luckyo7/MouseVR/Hardware/driver_board/production/JLCPCB BOM.xls

JLCPCB BOM Tool - BOM Matching
BOM name：bom-JLCPCB Assembly Order.xlsx |  |  | Download Time：2026-08-20 01:07:51 |  |  |  | * Our matching results are updated in real-time, but stock and prices may change. If it's been over 24 hours, please re-match before placing your order.
PCB Assembled Qty：5 |  |  | Est. Total Price：6.3515
Your BOM |  |  |  | Matched Parts |  |  |  |  |  |  | Order Information
Designator | Comment | Footprint | JLCPCB Part # | Matches | Part # | Manufacturer | Footprint | Description | Category | Warning | JLCPCB Part # | Product link | Lib Type | Qty | Source | Total Price ($)
C1 | 10u | 0805 |  | Unconfirmed | GRM21BR61H106KE43L | Murata Electronics | 0805 | 10uF 50V X5R ±10% 0805 Multilayer Ceramic Capacitors MLCC - SMD/SMT ROHS | Multilayer Ceramic Capacitors MLCC - SMD/SMT | 1.The comment (GRM21BR61H106KE43L) of this part does not match the one (10u) provided in your BOM. Please confirm; | C440198 | https://jlcpcb.com/partdetail/439567-GRM21BR61H106KE43L/C440198 | Basic | 5 | 5 JLCPCB | 1.2415
C2 | 1u | 0603 |  | Unconfirmed | CL10A105KB8NNNC | Samsung Electro-Mechanics | 0603 | 1uF 50V X5R ±10% 0603 Multilayer Ceramic Capacitors MLCC - SMD/SMT ROHS | Multilayer Ceramic Capacitors MLCC - SMD/SMT | 1.The comment (CL10A105KB8NNNC) of this part does not match the one (1u) provided in your BOM. Please confirm; | C15849 | https://jlcpcb.com/partdetail/16531-CL10A105KB8NNNC/C15849 | Basic | 20 | 20 JLCPCB | 0.544
C3,C4 | 100n | 0603 |  | Unconfirmed | CC0603KRX7R9BB104 | YAGEO | 0603 | 100nF 50V X7R ±10% 0603 Multilayer Ceramic Capacitors MLCC - SMD/SMT ROHS | Multilayer Ceramic Capacitors MLCC - SMD/SMT | 1.The comment (CC0603KRX7R9BB104) of this part does not match the one (100n) provided in your BOM. Please confirm; | C14663 | https://jlcpcb.com/partdetail/YAGEO-CC0603KRX7R9BB104/C14663 | Basic | 20 | 20 JLCPCB | 0.348
J2,J3 | Conn_01x12 | Hirose_FH12-12S-0.5SH_1x12-1MP_P0.50mm_Horizontal |  | Select by Customer | FH12-12S-0.5SH(55) | HRS(Hirose) | SMD,P=0.5mm,卧贴 | -40℃~+85℃ 0.3mm 0.5mm 12P 2mm Bottom Contact Gold Hinged Lid Phosphor bronze Surface Mount, Right Angle SMD,P=0.5mm,卧贴 FFC, FPC (Flat Flexible) Connector Assemblies ROHS | FFC, FPC (Flat Flexible) Connector Assemblies |  | C88360 | https://jlcpcb.com/partdetail/HRS_Hirose-FH12_12S_0_5SH_55/C88360 | Extended | 10 | 10 JLCPCB | 3.431
Q1 | Q_NPN_BEC | SOT-23 |  | Select by Customer | MMBT3904LT1G | onsemi | SOT-23 | -55℃~+150℃ 1 NPN 200mA 200mV 225mW 300MHz 40 40V 50nA 6V NPN SOT-23 Bipolar (BJT) ROHS | Bipolar (BJT) |  | C81464 | https://jlcpcb.com/partdetail/onsemi-MMBT3904LT1G/C81464 | Extended | 10 | 10 JLCPCB | 0.167
R1,R2,R3,R4,R5,R6 | 33R | 0603 |  | Unconfirmed | 0603WAF330JT5E | UNI-ROYAL(Uniroyal Elec) | 0603 | -55℃~+155℃ 100mW 33Ω 75V Thick Film Resistor ±1% ±100ppm/℃ 0603 Chip Resistor - Surface Mount ROHS | Chip Resistor - Surface Mount | 1.The comment (0603WAF330JT5E) of this part does not match the one (33R) provided in your BOM. Please confirm; | C23140 | https://jlcpcb.com/partdetail/23867-0603WAF330JT5E/C23140 | Basic | 40 | 40 JLCPCB | 0.188
R7 | 1K | 0603 |  | Unconfirmed | 0603WAF1001T5E | UNI-ROYAL(Uniroyal Elec) | 0603 | -55℃~+155℃ 100mW 1kΩ 75V Thick Film Resistor ±1% ±100ppm/℃ 0603 Chip Resistor - Surface Mount ROHS | Chip Resistor - Surface Mount | 1.The comment (0603WAF1001T5E) of this part does not match the one (1K) provided in your BOM. Please confirm; | C21190 | https://jlcpcb.com/partdetail/21904-0603WAF1001T5E/C21190 | Basic | 20 | 20 JLCPCB | 0.114
R10,R11 | 5R1 | 0603 |  | Unconfirmed | 0603WAF510KT5E | UNI-ROYAL(Uniroyal Elec) | 0603 | -55℃~+155℃ 100mW 5.1Ω 75V Thick Film Resistor ±1% ±200ppm/℃ 0603 Chip Resistor - Surface Mount ROHS | Chip Resistor - Surface Mount | 1.The comment (0603WAF510KT5E) of this part does not match the one (5R1) provided in your BOM. Please confirm; | C25197 | https://jlcpcb.com/partdetail/25940-0603WAF510KT5E/C25197 | Basic | 20 | 20 JLCPCB | 0.15
R12,R8 | 10K | 0603 |  | Unconfirmed | 0603WAF1002T5E | UNI-ROYAL(Uniroyal Elec) | 0603 | -55℃~+155℃ 100mW 10kΩ 75V Thick Film Resistor ±1% ±100ppm/℃ 0603 Chip Resistor - Surface Mount ROHS | Chip Resistor - Surface Mount | 1.The comment (0603WAF1002T5E) of this part does not match the one (10K) provided in your BOM. Please confirm; | C25804 | https://jlcpcb.com/partdetail/26547-0603WAF1002T5E/C25804 | Basic | 20 | 20 JLCPCB | 0.168
