luckyo7/MouseVR/Hardware/driver_board/driver_board.csv

Id | Designator | Footprint | Quantity | Designation | Supplier and ref
1 | C1 | C_0805_2012Metric | 1 | 10u
2 | C2 | C_0603_1608Metric | 1 | 1u
3 | C3, C4 | C_0603_1608Metric | 2 | 100n
4 | J2, J3 | Hirose_FH12-12S-0.5SH_1x12-1MP_P0.50mm_Horizontal | 2 | Conn_01x12
5 | Q1 | SOT-23 | 1 | Q_NPN_BEC
6 | R1, R2, R3, R4, R5, R6 | R_0603_1608Metric | 6 | 33R
7 | R7 | R_0603_1608Metric | 1 | 1K
8 | R8, R12 | R_0603_1608Metric | 2 | 10K
9 | R10, R11 | R_0603_1608Metric | 2 | 5R1
