luckyo7/MouseVR/Hardware/driver_board/.step

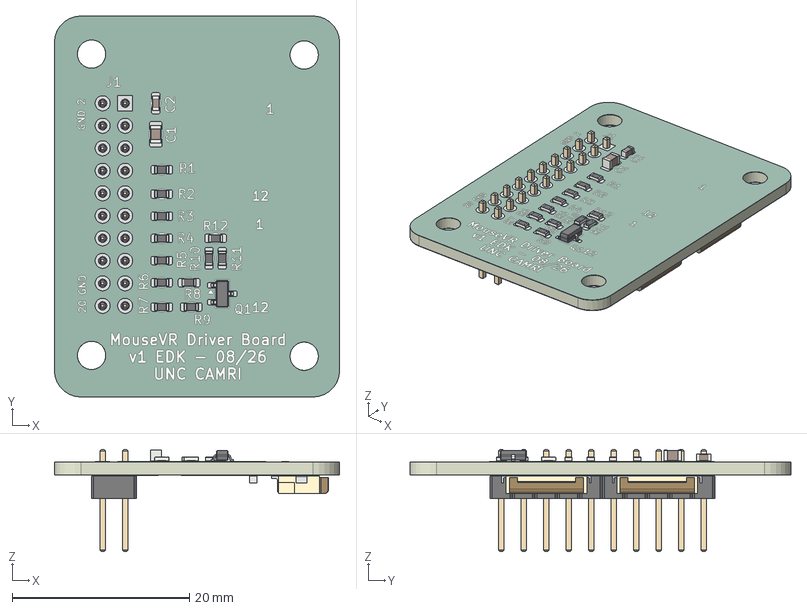
[picture p1: CAD file, 2026-09-29]
Hardware/driver_board/.step
32.2 x 43.0 x 11.5 mm
R_0603_1608Metric x 12
C_0805_2012Metric
C_0603_1608Metric x 3
SOT-23
PinHeader_2x10_P254mm_Vertical
lock x 2
pins x 2
driver_board-unsaved-export-gD1KjI_copper
driver_board-unsaved-export-gD1KjI_pad
driver_board-unsaved-export-gD1KjI_via
driver_board-unsaved-export-gD1KjI_silkscreen x 2
driver_board-unsaved-export-gD1KjI_soldermask x 2
driver_board-unsaved-export-gD1KjI_PCB
