luckyo7/MouseVR/Hardware/driver_board/driver_board.kicad_pcb

## KiCad design Hardware/driver_board/driver_board.kicad_pcb (2026-09-29)

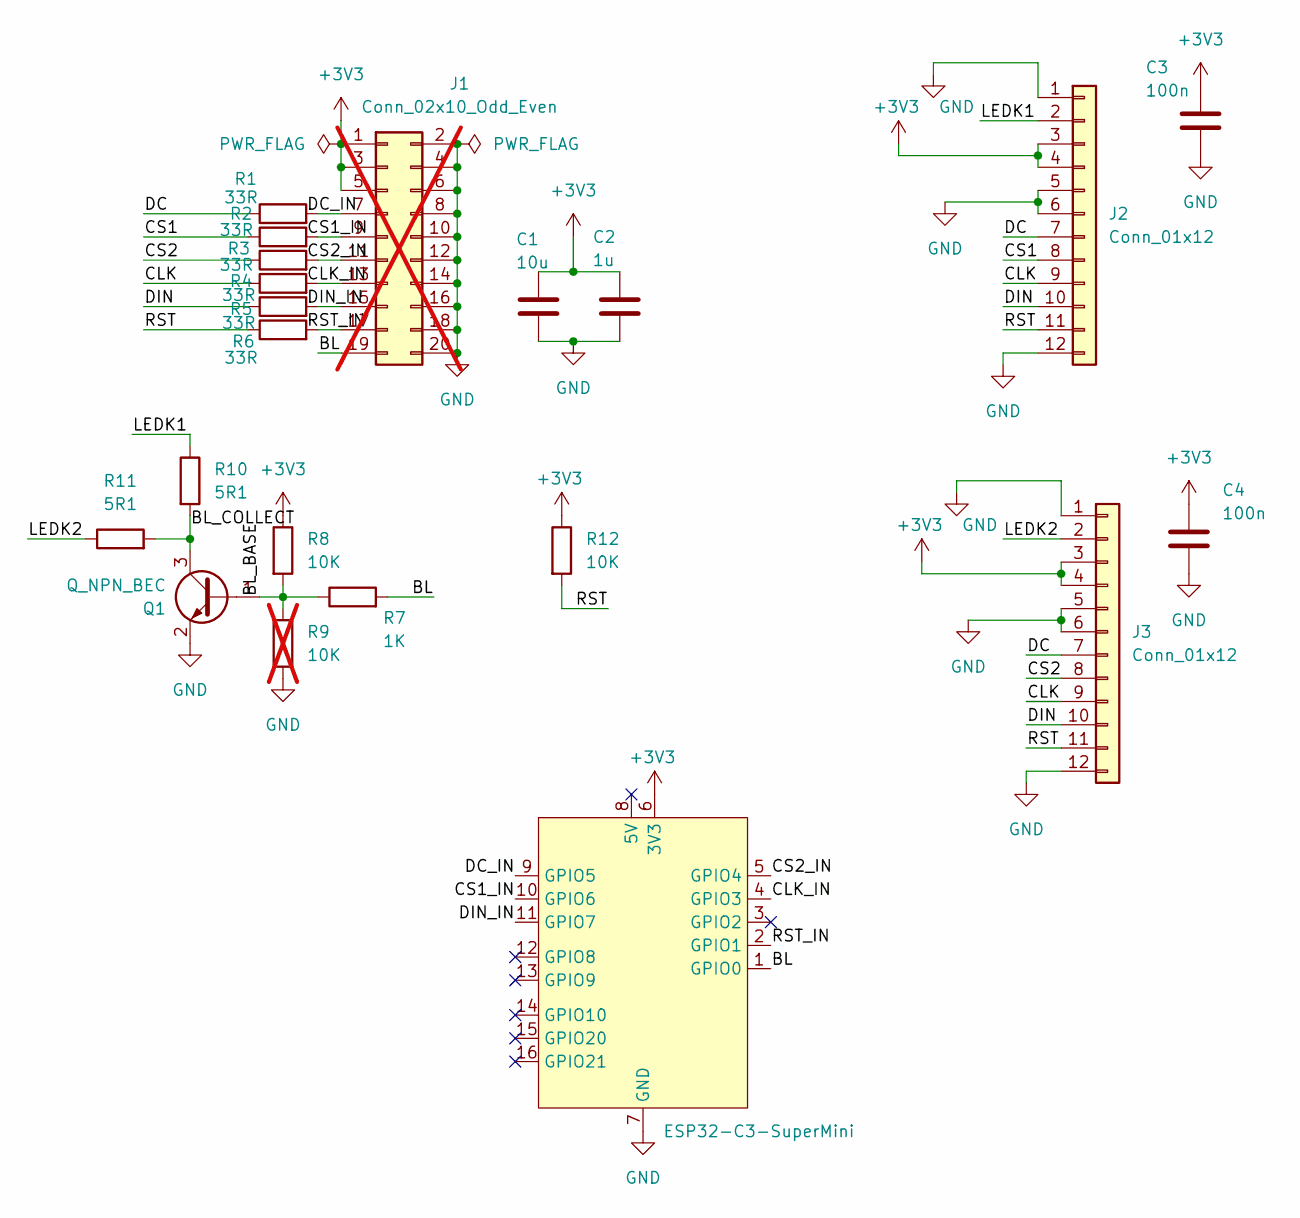
[picture p2: schematic driver_board.kicad_sch, MouseVR Driver Board]

Parts:
C1: 10u; C_0805_2012Metric
C2: 1u; C_0603_1608Metric
C3, C4: 100n; C_0603_1608Metric
J1: Conn_02x10_Odd_Even; PinHeader_2x10_P2.54mm_Vertical; not fitted
J2, J3: Conn_01x12; Hirose_FH12-12S-0.5SH_1x12-1MP_P0.50mm_Horizontal
Q1: Q_NPN_BEC; SOT-23
R1, R2, R3, R4, R5, R6: 33R; R_0603_1608Metric
R7: 1K; R_0603_1608Metric
R8, R12: 10K; R_0603_1608Metric
R9: 10K; R_0603_1608Metric; not fitted
R10, R11: 5R1; R_0603_1608Metric
U1: ESP32-C3-SuperMini

Connections:
+3V3: C1.1, C2.1, C3.1, C4.1, J1.1, J1.3, J1.5, J2.3, J2.4, J3.3, J3.4, R8.1, R12.1, U1.6 (3V3)
/BL: J1.19, R7.2, U1.1 (GPIO0)
/BL_BASE: Q1.1 (B), R7.1, R8.2, R9.1
/BL_COLLECT: Q1.3 (C), R10.2, R11.2
/CLK: J2.9, J3.9, R4.1
/CS1: J2.8, R2.1
/CS2: J3.8, R3.1
/DC: J2.7, J3.7, R1.1
/DIN: J2.10, J3.10, R5.1
/LEDK1: J2.2, R10.1
/LEDK2: J3.2, R11.1
/RST: J2.11, J3.11, R6.1, R12.2
GND: C1.2, C2.2, C3.2, C4.2, J1.2, J1.4, J1.6, J1.8, J1.10, J1.12, J1.14, J1.16, J1.18, J1.20, J2.1, J2.5, J2.6, J2.12, J2.MP, J3.1, J3.5, J3.6, J3.12, J3.MP, Q1.2 (E), R9.2, U1.7 (GND)
unnamed: J1.7, R1.2
unnamed: J1.9, R2.2
unnamed: J1.11, R3.2
unnamed: J1.13, R4.2
unnamed: J1.15, R5.2
unnamed: J1.17, R6.2

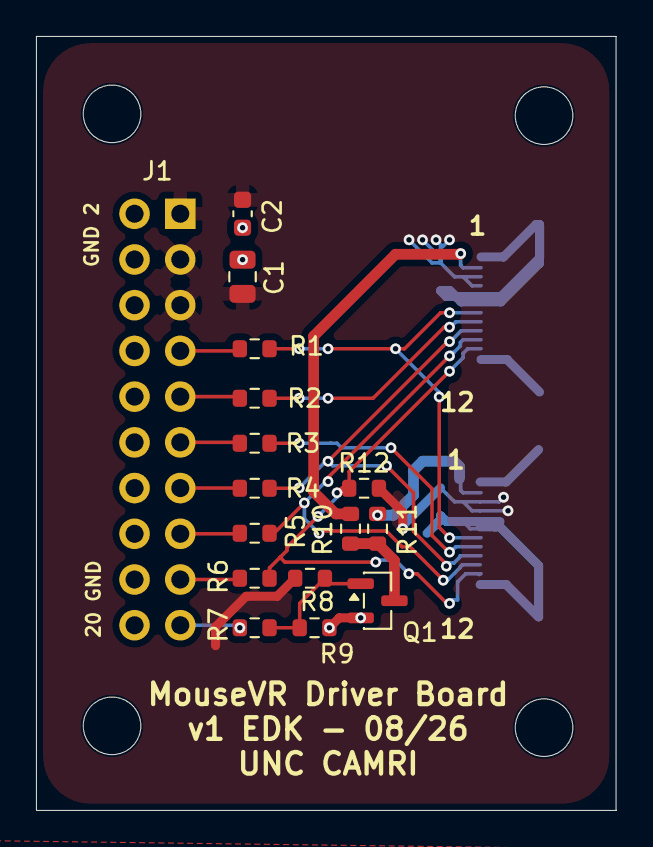
[picture p3: board driver_board.kicad_pcb from above]

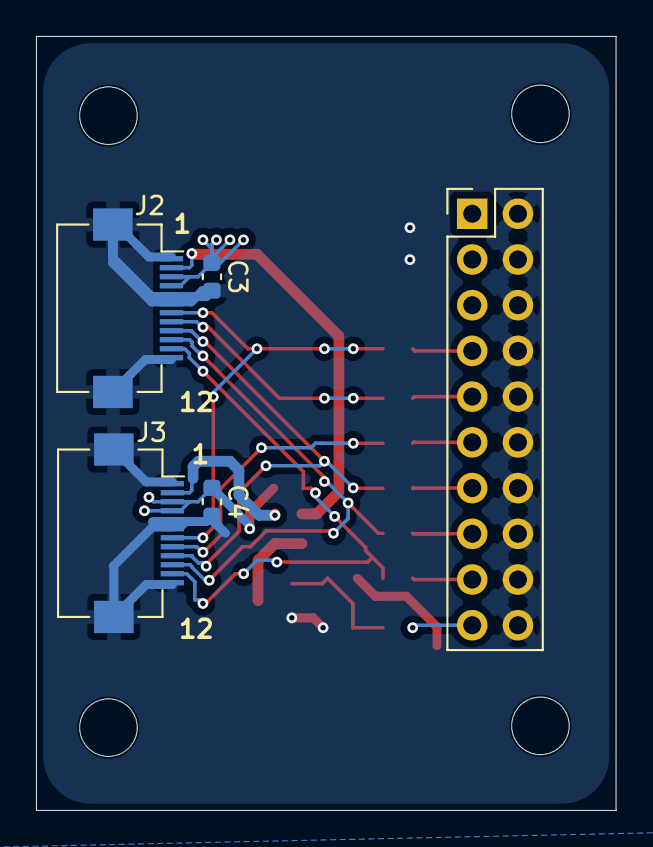
[picture p4: board driver_board.kicad_pcb from below]

Board: 2 copper layers, 32.2 x 43.0 mm, 20 parts (5 on the bottom side), 19 nets.
