luckyo7/MouseVR/(commit log)

2026-09-29 Port to ESP32-C3 driver board with dual panels and animated test
    Move from the ESP32-S3 dev board to the ESP32-C3 SuperMini driving the
    MouseVR driver board: new pin map, both GC9D01 panels sharing the bus and
    selected by CS1/CS2 in main.cpp (TFT_CS=-1), and TFT_eSPI fixes for the C3
    SPI register base and for building with TFT_CS disabled.
    The test image now animates: the checkerboard scrolls diagonally and cycles
    complementary hues so bus errors over the 5 m cable show up as tearing,
    shifted rows or off colours. The left panel's mirror + sphere warp is
    precomputed once, giving ~17 fps for both panels at 27 MHz SPI.
    Adds disabled-by-default diagnostics: BL_HIZ_TEST (backlight driven by R8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
    [main.cpp]
2026-09-29 Add KiCad projects for the driver and adapter boards
    Driver board (ESP32-C3 SuperMini header J1, 33R series resistors, backlight
    switch and the two FH12 panel connectors) with gerbers, JLCPCB production
    files and a STEP export, plus the FPC pitch adapter board.
    Ignore macOS .DS_Store files and KiCad's local history repos, lock files,
    backups and stray unsaved-export settings.
    [.step, JLCPCB BOM.xls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]
2026-10-05 Warp both panels, drop LVGL, run SPI at 10 MHz with boot diagnostics
    Both panels now show the sphere-warped checkerboard; the mirrored left
    panel reuses the same precomputed warp map read right to left.
    LVGL was never used by the firmware and its v8.3 lv_conf.h didn't match
    the v9.5 library, so remove the dependency and the config.
    SPI drops from 27 to 10 MHz: after the cable to the driver board was
    reworked, faster clocks leave the panels blank or banded.
    Boot log now prints the reset reason and a boot count kept in RTC memory,
    so brownout or crash loops are visible. BL_EARLY_TEST (off) lights the
    backlight before init instead of fading it in after the first frame.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
    [main.cpp]
